ucw-gadgets/ventilation-control/README.md

# ventilation-control
Board for controlling ventilation system
