ucw-gadgets/ventilation-control/hw/ventilation_control/ventilation_control.kicad_pcb

## KiCad design hw/ventilation_control/ventilation_control.kicad_pcb (2022-02-05)

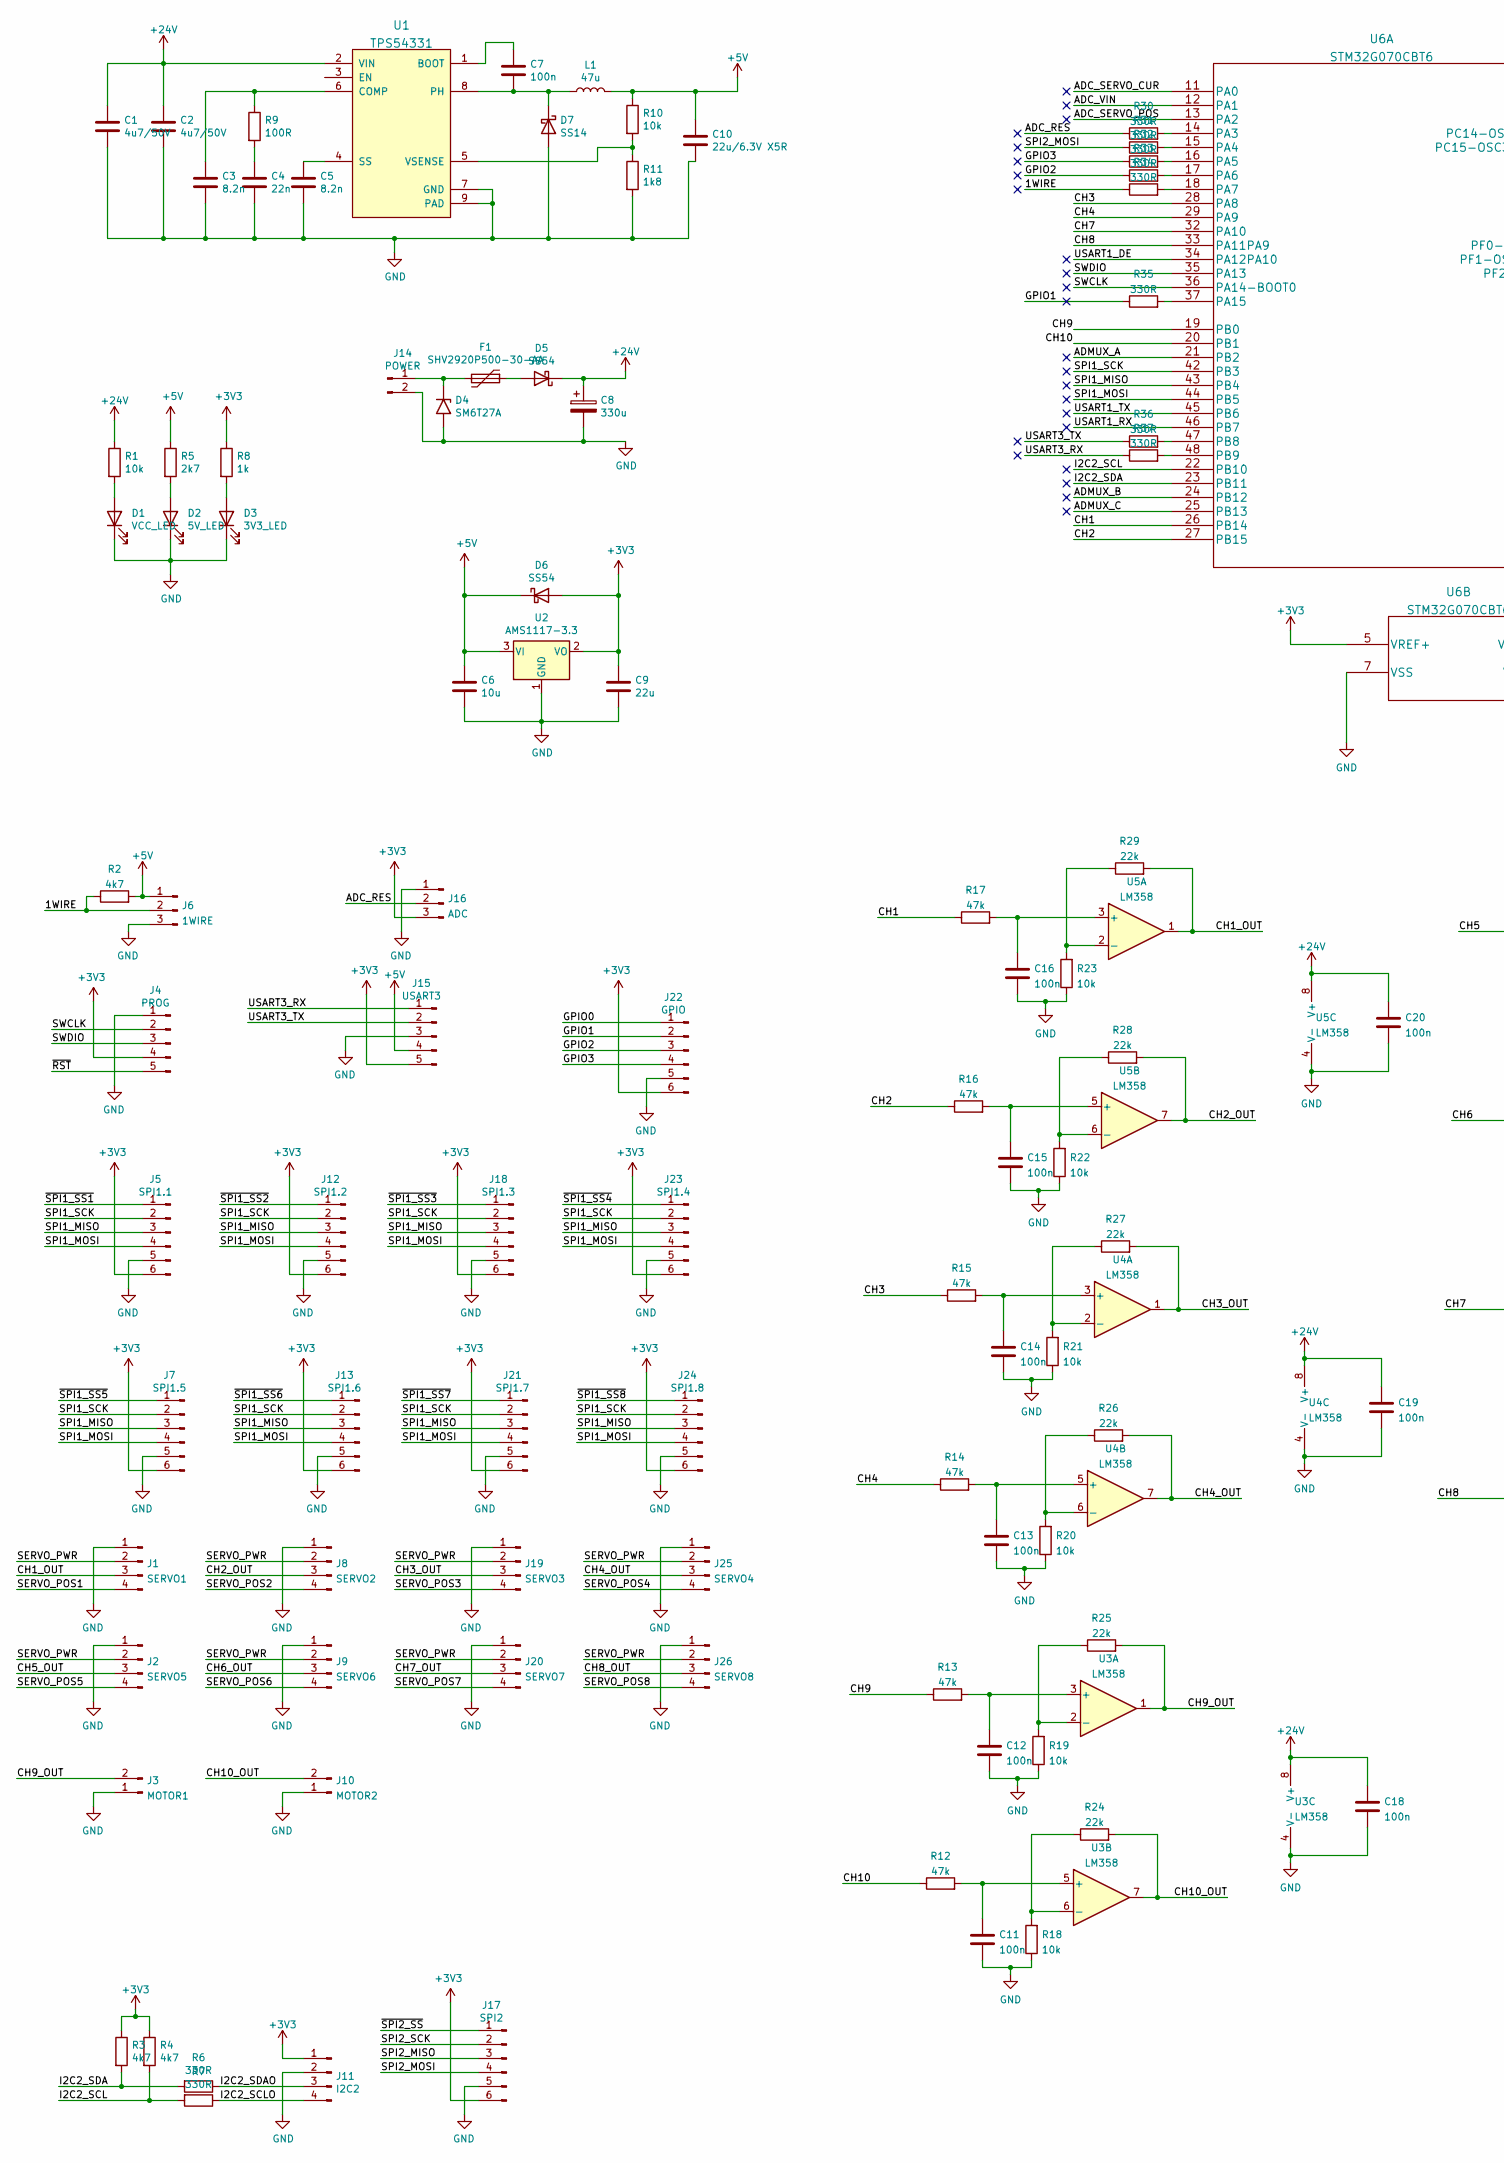
[picture p1: schematic ventilation_control.kicad_sch, part in row 1, column 1]

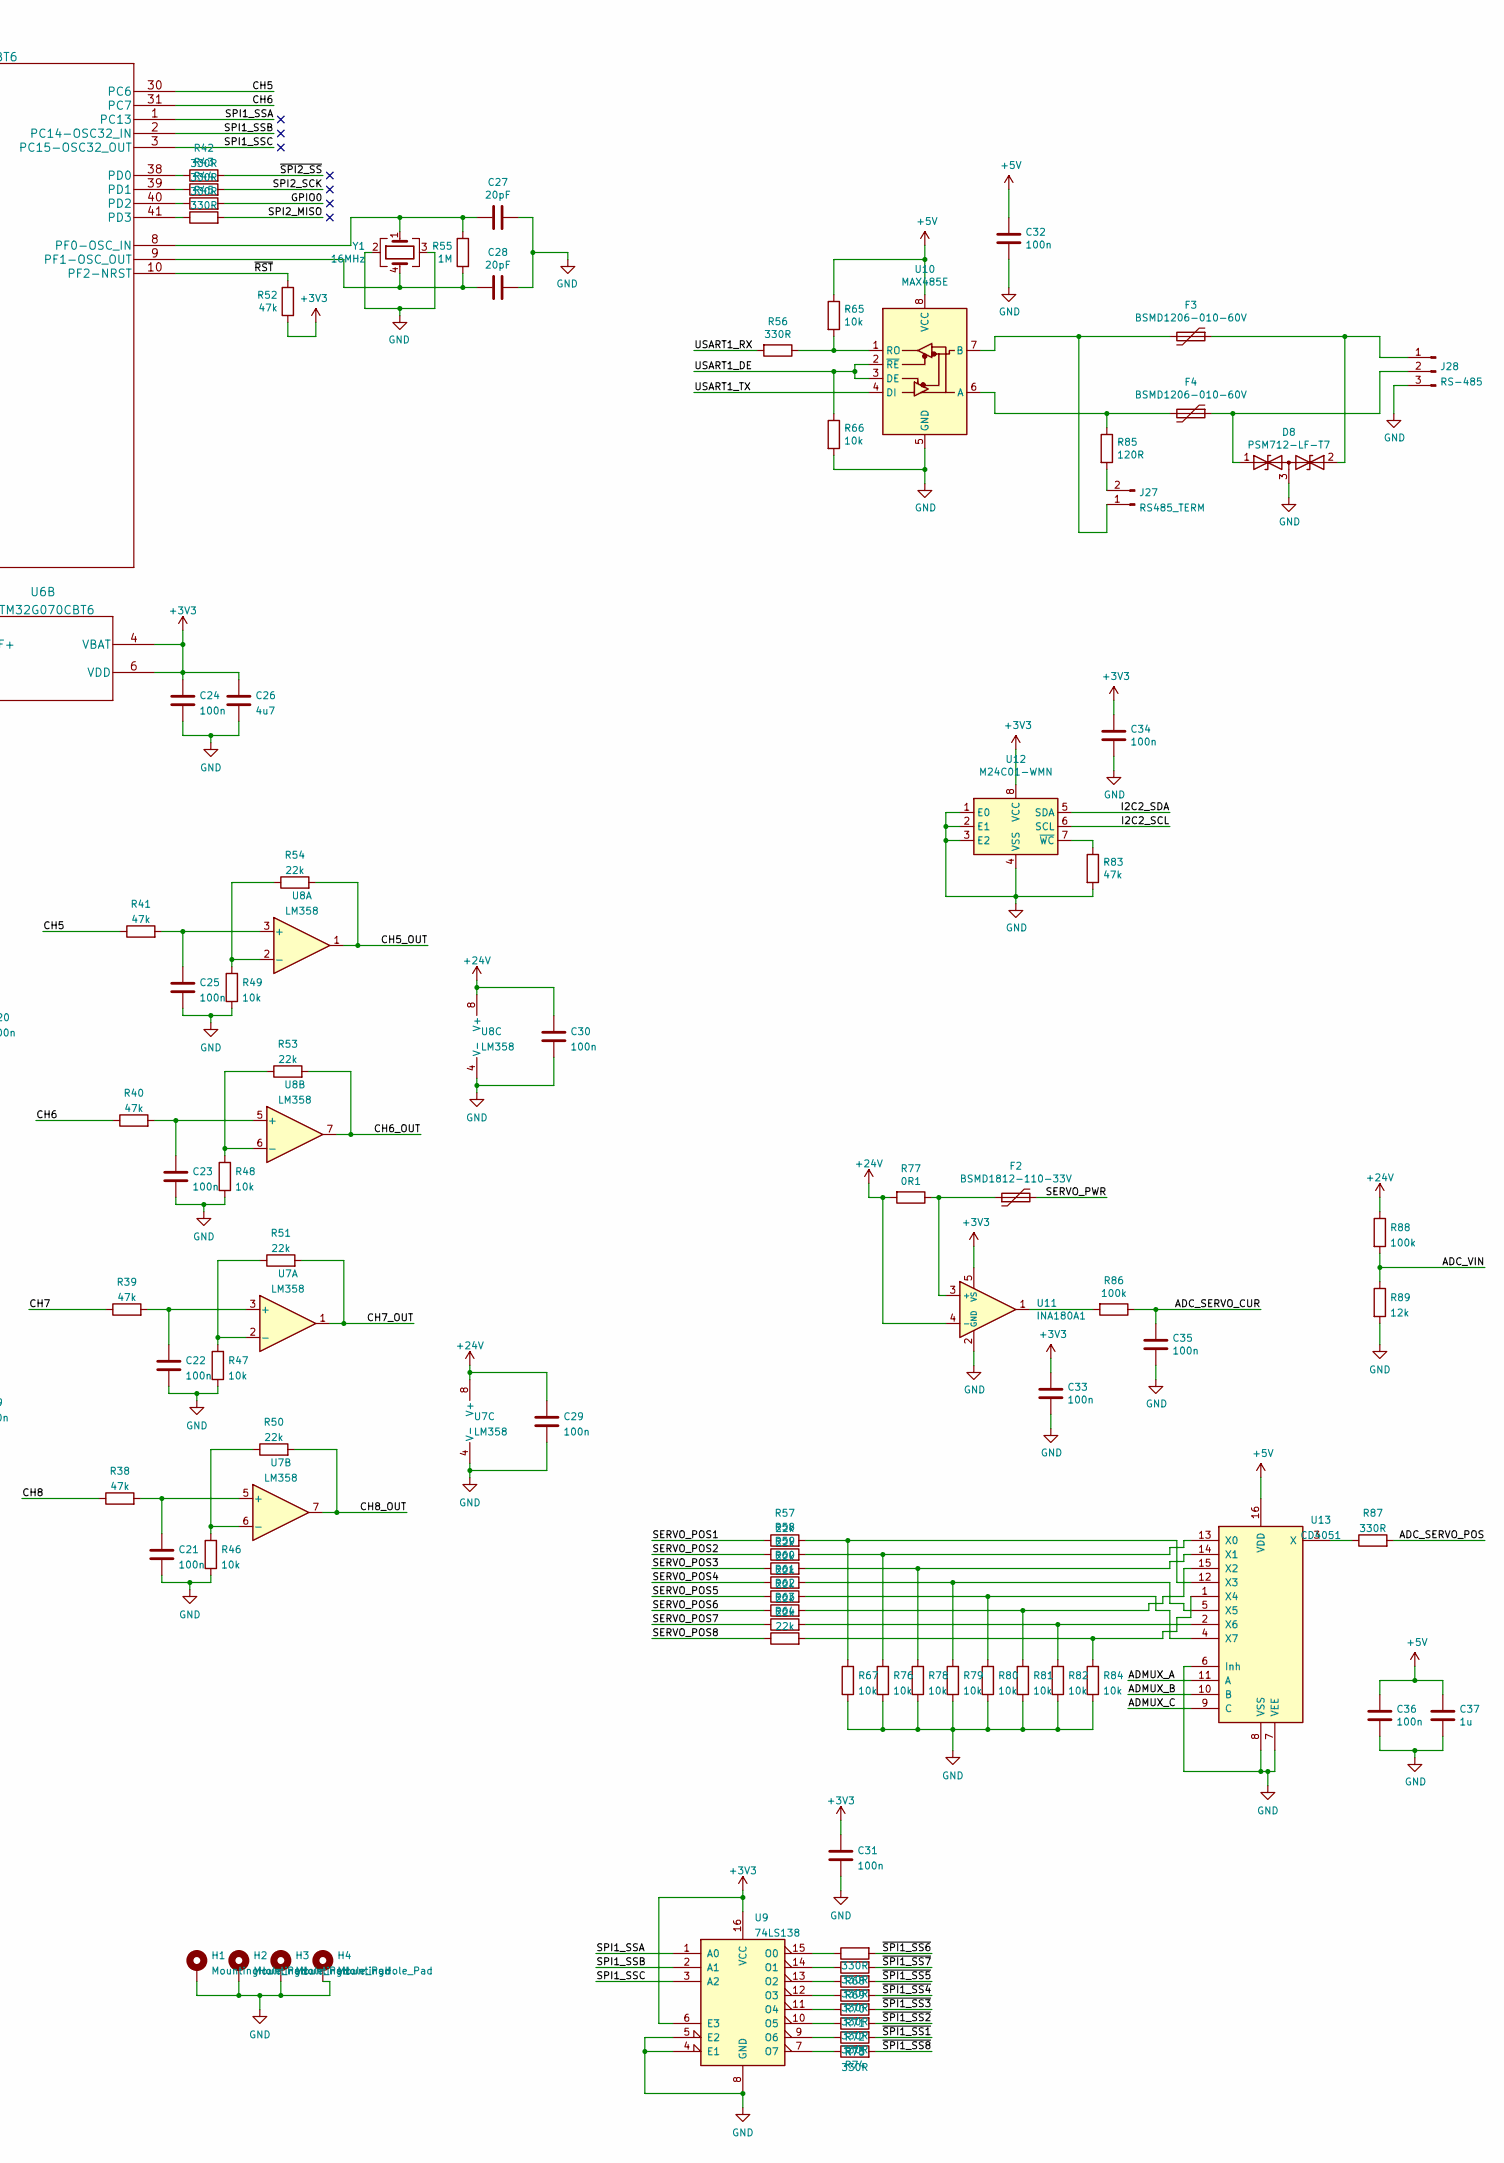
[picture p2: schematic ventilation_control.kicad_sch, part in row 1, column 2]

Parts:
C1, C2: 4u7/50V; C_1206_3216Metric; LCSC C29823
C3, C5: 8.2n; C_0603_1608Metric; LCSC C27920
C4: 22n; C_0603_1608Metric; LCSC C21122
C6: 10u; C_0603_1608Metric; LCSC C19702
C7, C11, C12, C13, C14, C15, C16, C18, C19, C20, C21, C22, C23, C24, C25, C29, C30, C31, C32, C33, C34, C35, C36: 100n; C_0603_1608Metric; LCSC C14663
C8: 330u; CP_Radial_D10.0mm_P5.00mm
C9: 22u; C_0603_1608Metric; LCSC C59461
C10: 22u/6.3V X5R; C_0603_1608Metric; LCSC C59461
C26: 4u7; C_1206_3216Metric; LCSC C29823
C27, C28: 20pF; C_0603_1608Metric; LCSC C1648
C37: 1u; C_0603_1608Metric; LCSC C15849
D1: VCC_LED; LED_0603_1608Metric; LCSC C72043
D2: 5V_LED; LED_0603_1608Metric; LCSC C72043
D3: 3V3_LED; LED_0603_1608Metric; LCSC C72043
D4: SM6T27A; D_SMB; LCSC C133693
D5, D6: SS54; D_SMA; LCSC C22452
D7: SS14; D_SMA; LCSC C2480
D8: PSM712-LF-T7; SOT-23; LCSC C32677
F1: SHV2920P500-30-AA; Fuse_2920_7451Metric; LCSC C495350
F2: BSMD1812-110-33V; Fuse_1812_4532Metric; LCSC C883150
F3, F4: BSMD1206-010-60V; Fuse_1206_3216Metric; LCSC C883116
H1, H2, H3, H4: MountingHole_Pad; MountingHole_3.2mm_M3_Pad_Via
J1: SERVO1; Molex_KK-254_AE-6410-04A_1x04_P2.54mm_Vertical
J2: SERVO5; Molex_KK-254_AE-6410-04A_1x04_P2.54mm_Vertical
J3: MOTOR1; Molex_KK-254_AE-6410-02A_1x02_P2.54mm_Vertical
J4: PROG; Molex_KK-254_AE-6410-05A_1x05_P2.54mm_Vertical
J5: SPI1.1; Molex_KK-254_AE-6410-06A_1x06_P2.54mm_Vertical
J6: 1WIRE; Molex_KK-254_AE-6410-03A_1x03_P2.54mm_Vertical
J7: SPI1.5; Molex_KK-254_AE-6410-06A_1x06_P2.54mm_Vertical
J8: SERVO2; Molex_KK-254_AE-6410-04A_1x04_P2.54mm_Vertical
J9: SERVO6; Molex_KK-254_AE-6410-04A_1x04_P2.54mm_Vertical
J10: MOTOR2; Molex_KK-254_AE-6410-02A_1x02_P2.54mm_Vertical
J11: I2C2; Molex_KK-254_AE-6410-04A_1x04_P2.54mm_Vertical
J12: SPI1.2; Molex_KK-254_AE-6410-06A_1x06_P2.54mm_Vertical
J13: SPI1.6; Molex_KK-254_AE-6410-06A_1x06_P2.54mm_Vertical
J14: POWER; PhoenixContact_MCV_1,5_2-GF-3.81_1x02_P3.81mm_Vertical_Thre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
J15: USART3; Molex_KK-254_AE-6410-05A_1x05_P2.54mm_Vertical
J16: ADC; Molex_KK-254_AE-6410-03A_1x03_P2.54mm_Vertical
J17: SPI2; Molex_KK-254_AE-6410-06A_1x06_P2.54mm_Vertical
J18: SPI1.3; Molex_KK-254_AE-6410-06A_1x06_P2.54mm_Vertical
J19: SERVO3; Molex_KK-254_AE-6410-04A_1x04_P2.54mm_Vertical
J20: SERVO7; Molex_KK-254_AE-6410-04A_1x04_P2.54mm_Vertical
J21: SPI1.7; Molex_KK-254_AE-6410-06A_1x06_P2.54mm_Vertical
J22: GPIO; Molex_KK-254_AE-6410-06A_1x06_P2.54mm_Vertical
J23: SPI1.4; Molex_KK-254_AE-6410-06A_1x06_P2.54mm_Vertical
J24: SPI1.8; Molex_KK-254_AE-6410-06A_1x06_P2.54mm_Vertical
J25: SERVO4; Molex_KK-254_AE-6410-04A_1x04_P2.54mm_Vertical
J26: SERVO8; Molex_KK-254_AE-6410-04A_1x04_P2.54mm_Vertical
J27: RS485_TERM; PinHeader_1x02_P2.54mm_Vertical
J28: RS-485; PhoenixContact_MCV_1,5_3-G-3.81_1x03_P3.81mm_Vertical
L1: 47u; L_Bourns_SRP7028A_7.3x6.6mm; LCSC C436585
R1, R10, R18, R19, R20, R21, R22, R23, R46, R47, R48, R49, R65, R66, R67, R76, R78, R79, R80, R81, R82, R84: 10k; R_0603_1608Metric; LCSC C25804
R2, R3, R4: 4k7; R_0603_1608Metric; LCSC C23162
R5: 2k7; R_0603_1608Metric; LCSC C13167
R6, R7, R30, R31, R32, R33, R34, R35, R36, R37, R42, R43, R44, R45, R56, R68, R69, R70, R71, R72, R73, R74, R75, R87: 330R; R_0603_1608Metric; LCSC C23138
R8: 1k; R_0603_1608Metric; LCSC C21190
R9: 100R; R_0603_1608Metric; LCSC C22775
R11: 1k8; R_0603_1608Metric; LCSC C4177
R12, R13, R14, R15, R16, R17, R38, R39, R40, R41, R52, R83: 47k; R_0603_1608Metric; LCSC C25819
R24, R25, R26, R27, R28, R29, R50, R51, R53, R54, R57, R58, R59, R60, R61, R62, R63, R64: 22k; R_0603_1608Metric; LCSC C31850
R55: 1M; R_0603_1608Metric; LCSC C22935
R77: 0R1; R_1206_3216Metric; LCSC C25334
R85: 120R; R_0603_1608Metric; LCSC C22787
R86, R88: 100k; R_0603_1608Metric; LCSC C25803
R89: 12k; R_0603_1608Metric; LCSC C22790
U1: TPS54331; SOIC-8_3.9x4.9mm_P1.27mm; LCSC C9865
U2: AMS1117-3.3; SOT-223-3_TabPin2; LCSC C6186
U3, U4, U5, U7, U8: LM358; SO-8_3.9x4.9mm_P1.27mm; LCSC C7950
U6: STM32G070CBT6; LQFP-48_7x7mm_P0.5mm
U9: 74LS138; SO-16_3.9x9.9mm_P1.27mm; LCSC C5602
U10: MAX485E; SOIC-8_3.9x4.9mm_P1.27mm; LCSC C6855
U11: INA180A1; SOT-23-5; LCSC C122228
U12: M24C01-WMN; SOIC-8_3.9x4.9mm_P1.27mm; LCSC C79988
U13: CD4051; SO-16_3.9x9.9mm_P1.27mm; LCSC C21379
Y1: 16MHz; Crystal_SMD_3225-4Pin_3.2x2.5mm; LCSC C13738

Connections:
+3V3: C9.1, C24.1, C26.1, C31.1, C33.1, C34.1, D6.2 (A), J4.4, J5.6, J7.6, J11.1, J12.6, J13.6, J15.5, J16.3, J17.6, J18.6, J21.6, J22.6, J23.6, J24.6, R3.1, R4.1, R8.1, R52.2, U2.2 (VO), U6.4 (VBAT), U6.5 (VREF+), U6.6 (VDD), U9.6 (E3), U9.16 (VCC), U11.5 (VS), U12.8 (VCC)
+5V: C6.1, C10.1, C32.1, C36.1, C37.1, D6.1 (K), J6.1, J15.4, L1.2, R2.2, R5.1, R10.1, R65.1, U2.3 (VI), U10.8 (VCC), U13.16 (VDD)
+24V: C1.1, C2.1, C8.1, C18.1, C19.1, C20.1, C29.1, C30.1, D5.1 (K), R1.1, R77.2, R88.1, U1.2 (VIN), U3.8 (V+), U4.8 (V+), U5.8 (V+), U7.8 (V+), U8.8 (V+), U11.4 (-)
/1WIRE: J6.2, R2.1, R34.1
/ADC_RES: J16.2, R30.1
/ADC_SERVO_CUR: C35.1, R86.1, U6.11 (PA0)
/ADC_SERVO_POS: R87.2, U6.13 (PA2)
/ADC_VIN: R88.2, R89.1, U6.12 (PA1)
/ADMUX_A: U6.21 (PB2), U13.11 (A)
/ADMUX_B: U6.24 (PB12), U13.10 (B)
/ADMUX_C: U6.25 (PB13), U13.9 (C)
/CH1: R17.1, U6.26 (PB14)
/CH1_OUT: J1.3, R29.2, U5.1
/CH2: R16.1, U6.27 (PB15)
/CH2_OUT: J8.3, R28.2, U5.7
/CH3: R15.1, U6.28 (PA8)
/CH3_OUT: J19.3, R27.2, U4.1
/CH4: R14.1, U6.29 (PA9)
/CH4_OUT: J25.3, R26.2, U4.7
/CH5: R41.1, U6.30 (PC6)
/CH5_OUT: J2.3, R54.2, U8.1
/CH6: R40.1, U6.31 (PC7)
/CH6_OUT: J9.3, R53.2, U8.7
/CH7: R39.1, U6.32 (PA10)
/CH7_OUT: J20.3, R51.2, U7.1
/CH8: R38.1, U6.33 (PA11PA9)
/CH8_OUT: J26.3, R50.2, U7.7
/CH9: R13.1, U6.19 (PB0)
/CH9_OUT: J3.2, R25.2, U3.1
/CH10: R12.1, U6.20 (PB1)
/CH10_OUT: J10.2, R24.2, U3.7
/GPIO0: J22.1, R44.2
/GPIO1: J22.2, R35.1
/GPIO2: J22.3, R33.1
/GPIO3: J22.4, R32.1
/I2C2_SCL: R4.2, R7.2, U6.22 (PB10), U12.6 (SCL)
/I2C2_SCLO: J11.4, R7.1
/I2C2_SDA: R3.2, R6.2, U6.23 (PB11), U12.5 (SDA)
/I2C2_SDAO: J11.3, R6.1
/SERVO_POS1: J1.4, R57.1
/SERVO_POS2: J8.4, R58.1
/SERVO_POS3: J19.4, R59.1
/SERVO_POS4: J25.4, R60.1
/SERVO_POS5: J2.4, R61.1
/SERVO_POS6: J9.4, R62.1
/SERVO_POS7: J20.4, R63.1
/SERVO_POS8: J26.4, R64.1
/SERVO_PWR: F2.2, J1.2, J2.2, J8.2, J9.2, J19.2, J20.2, J25.2, J26.2
/SPI1_MISO: J5.3, J7.3, J12.3, J13.3, J18.3, J21.3, J23.3, J24.3, U6.43 (PB4)
/SPI1_MOSI: J5.4, J7.4, J12.4, J13.4, J18.4, J21.4, J23.4, J24.4, U6.44 (PB5)
/SPI1_SCK: J5.2, J7.2, J12.2, J13.2, J18.2, J21.2, J23.2, J24.2, U6.42 (PB3)
/SPI1_SSA: U6.1 (PC13), U9.1 (A0)
/SPI1_SSB: U6.2 (PC14-OSC32_IN), U9.2 (A1)
/SPI1_SSC: U6.3 (PC15-OSC32_OUT), U9.3 (A2)
/SPI2_MISO: J17.3, R45.2
/SPI2_MOSI: J17.4, R31.1
/SPI2_SCK: J17.2, R43.2
/SWCLK: J4.2, U6.36 (PA14-BOOT0)
/SWDIO: J4.3, U6.35 (PA13)
/USART1_DE: R66.1, U6.34 (PA12PA10), U10.2 (~RE), U10.3 (DE)
/USART1_RX: R56.2, U6.46 (PB7)
/USART1_TX: U6.45 (PB6), U10.4 (DI)
/USART3_RX: J15.1, R37.1
/USART3_TX: J15.2, R36.1
/~RST: J4.5, R52.1, U6.10 (PF2-NRST)
/~SPI1_SS1: J5.1, R74.2
/~SPI1_SS2: J12.1, R73.2
/~SPI1_SS3: J18.1, R72.2
/~SPI1_SS4: J23.1, R71.2
/~SPI1_SS5: J7.1, R70.2
/~SPI1_SS6: J13.1, R68.2
/~SPI1_SS7: J21.1, R69.2
/~SPI1_SS8: J24.1, R75.2
/~SPI2_SS: J17.1, R42.2
GND: C1.2, C2.2, C3.2, C4.2, C5.2, C6.2, C8.2, C9.2, C10.2, C11.2, C12.2, C13.2, C14.2, C15.2, C16.2, C18.2, C19.2, C20.2, C21.2, C22.2, C23.2, C24.2, C25.2, C26.2, C27.2, C28.2, C29.2, C30.2, C31.2, C32.2, C33.2, C34.2, C35.2, C36.2, C37.2, D1.1 (K), D2.1 (K), D3.1 (K), D4.2 (A2), D7.2 (A), D8.3 (common), H1.1, H2.1, H3.1, H4.1, J1.1, J2.1, J3.1, J4.1, J5.5, J6.3, J7.5, J8.1, J9.1, J10.1, J11.2, J12.5, J13.5, J14.2, J15.3, J16.1, J17.5, J18.5, J19.1, J20.1, J21.5, J22.5, J23.5, J24.5, J25.1, J26.1, J28.3, R11.2, R18.1, R19.1, R20.1, R21.1, R22.1, R23.1, R46.1, R47.1, R48.1, R49.1, R66.2, R67.1, R76.1, R78.1, R79.1, R80.1, R81.1, R82.1, R83.2, R84.1, R89.2, U1.7 (GND), U1.9 (PAD), U2.1 (GND), U3.4 (V-), U4.4 (V-), U5.4 (V-), U6.7 (VSS), U7.4 (V-), U8.4 (V-), U9.4 (E1), U9.5 (E2), U9.8 (GND), U10.5 (GND), U11.2 (GND), U12.1 (E0), U12.2 (E1), U12.3 (E2), U12.4 (VSS), U13.6 (Inh), U13.7 (VEE), U13.8 (VSS), Y1.2, Y1.3
unnamed: C3.1, R9.1, U1.6 (COMP)
unnamed: C4.1, R9.2
unnamed: C5.1, U1.4 (SS)
unnamed: C7.1, U1.1 (BOOT)
unnamed: C7.2, D7.1 (K), L1.1, U1.8 (PH)
unnamed: C11.1, R12.2, U3.5 (+)
unnamed: C12.1, R13.2, U3.3 (+)
unnamed: C13.1, R14.2, U4.5 (+)
unnamed: C14.1, R15.2, U4.3 (+)
unnamed: C15.1, R16.2, U5.5 (+)
unnamed: C16.1, R17.2, U5.3 (+)
unnamed: C21.1, R38.2, U7.5 (+)
unnamed: C22.1, R39.2, U7.3 (+)
unnamed: C23.1, R40.2, U8.5 (+)
unnamed: C25.1, R41.2, U8.3 (+)
unnamed: C27.1, R55.1, U6.8 (PF0-OSC_IN), Y1.1
unnamed: C28.1, R55.2, U6.9 (PF1-OSC_OUT), Y1.4
unnamed: D1.2 (A), R1.2
unnamed: D2.2 (A), R5.2
unnamed: D3.2 (A), R8.2
unnamed: D4.1 (A1), F1.2, J14.1
unnamed: D5.2 (A), F1.1
unnamed: D8.1 (A1), F4.1, J28.2
unnamed: D8.2 (A2), F3.1, J28.1
unnamed: F2.1, R77.1, U11.3 (+)
unnamed: F3.2, J27.1, U10.7 (B)
unnamed: F4.2, R85.1, U10.6 (A)
unnamed: J27.2, R85.2
unnamed: R10.2, R11.1, U1.5 (VSENSE)
unnamed: R18.2, R24.1, U3.6 (-)
unnamed: R19.2, R25.1, U3.2 (-)
unnamed: R20.2, R26.1, U4.6 (-)
unnamed: R21.2, R27.1, U4.2 (-)
unnamed: R22.2, R28.1, U5.6 (-)
unnamed: R23.2, R29.1, U5.2 (-)
unnamed: R30.2, U6.14 (PA3)
unnamed: R31.2, U6.15 (PA4)
unnamed: R32.2, U6.16 (PA5)
unnamed: R33.2, U6.17 (PA6)
unnamed: R34.2, U6.18 (PA7)
unnamed: R35.2, U6.37 (PA15)
unnamed: R36.2, U6.47 (PB8)
unnamed: R37.2, U6.48 (PB9)
unnamed: R42.1, U6.38 (PD0)
unnamed: R43.1, U6.39 (PD1)
unnamed: R44.1, U6.40 (PD2)
unnamed: R45.1, U6.41 (PD3)
unnamed: R46.2, R50.1, U7.6 (-)
unnamed: R47.2, R51.1, U7.2 (-)
unnamed: R48.2, R53.1, U8.6 (-)
unnamed: R49.2, R54.1, U8.2 (-)
unnamed: R56.1, R65.2, U10.1 (RO)
unnamed: R57.2, R67.2, U13.12 (X3)
unnamed: R58.2, R76.2, U13.13 (X0)
unnamed: R59.2, R78.2, U13.14 (X1)
unnamed: R60.2, R79.2, U13.5 (X5)
unnamed: R61.2, R80.2, U13.4 (X7)
unnamed: R62.2, R81.2, U13.15 (X2)
unnamed: R63.2, R82.2, U13.2 (X6)
unnamed: R64.2, R84.2, U13.1 (X4)
unnamed: R68.1, U9.15 (O0)
unnamed: R69.1, U9.14 (O1)
unnamed: R70.1, U9.13 (O2)
unnamed: R71.1, U9.12 (O3)
unnamed: R72.1, U9.11 (O4)
unnamed: R73.1, U9.10 (O5)
unnamed: R74.1, U9.9 (O6)
unnamed: R75.1, U9.7 (O7)
unnamed: R83.1, U12.7 (~WC)
unnamed: R86.2, U11.1
unnamed: R87.1, U13.3 (X)

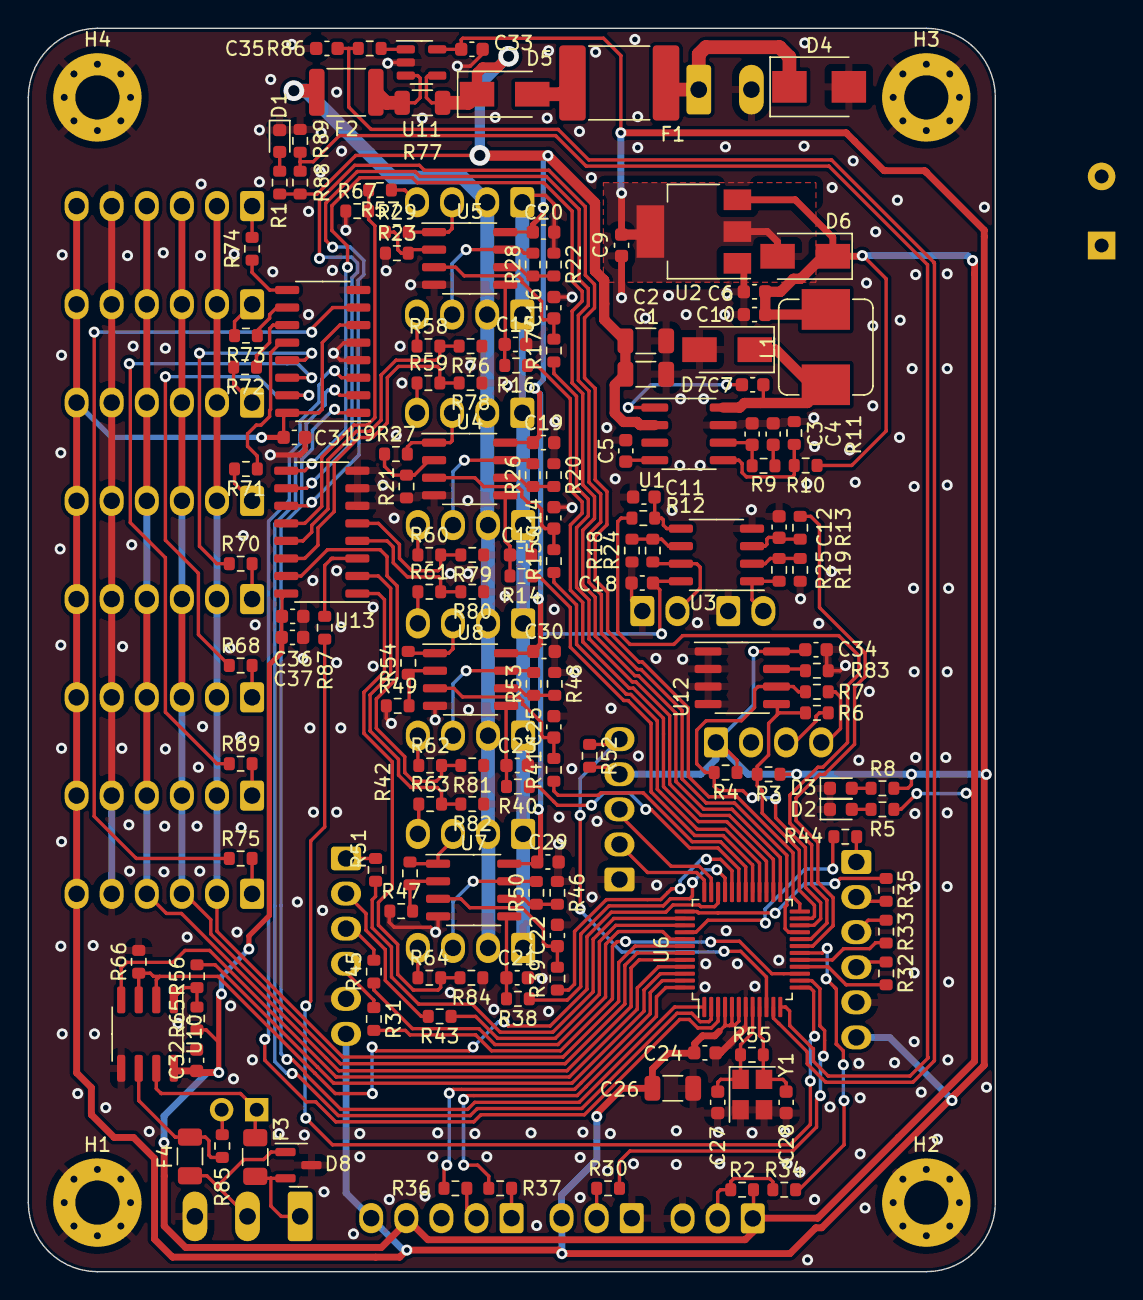
[picture p3: board ventilation_control.kicad_pcb from above]

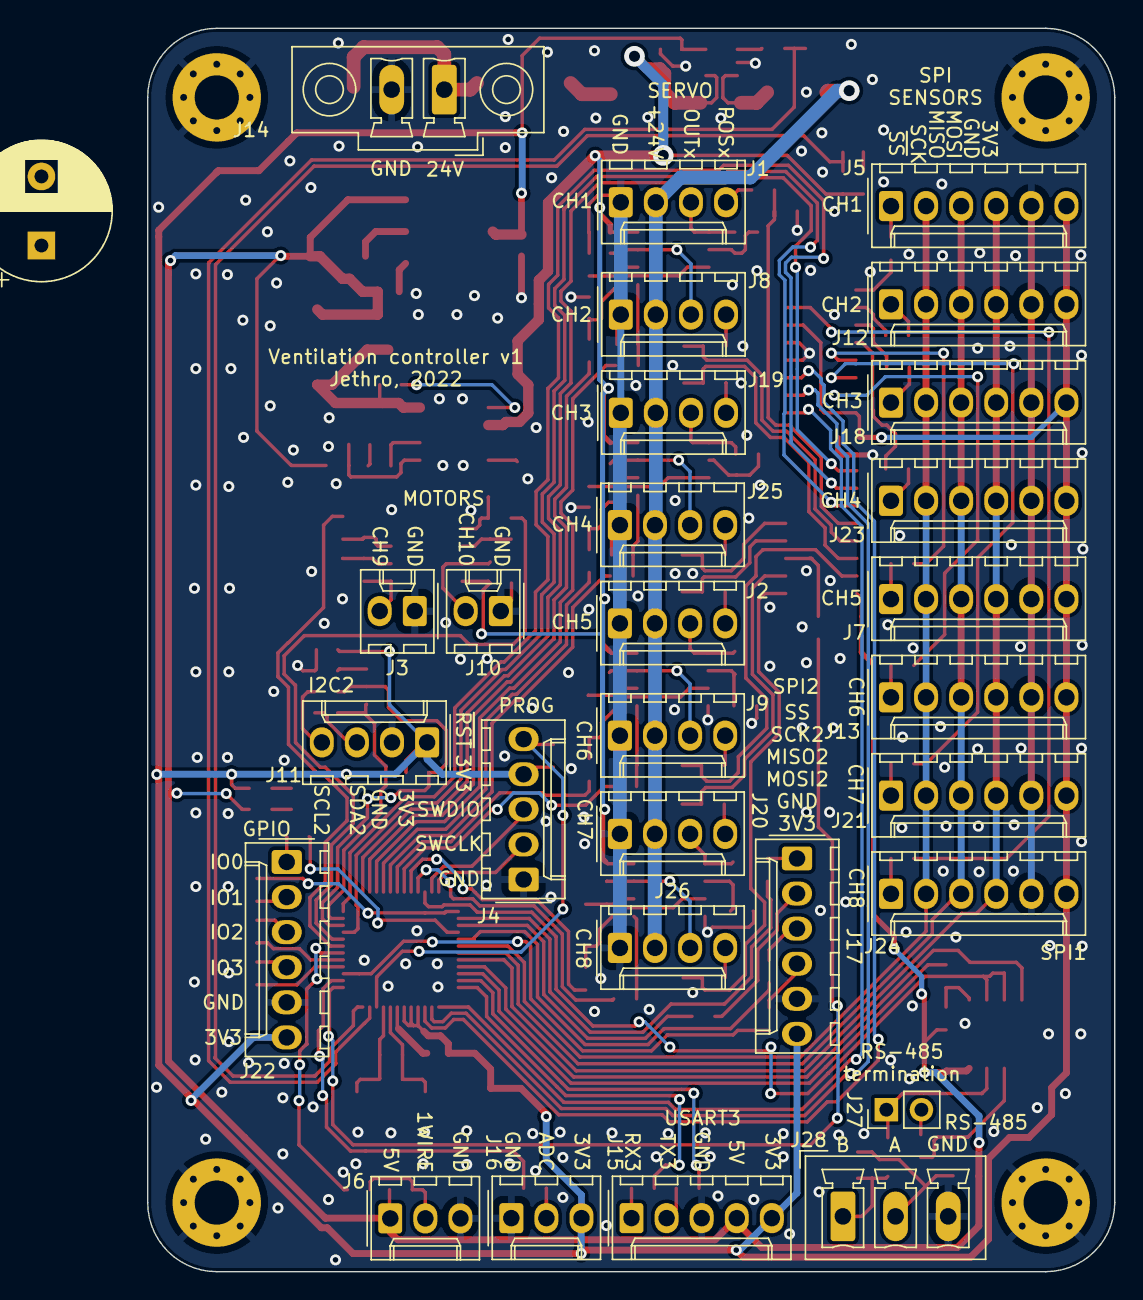
[picture p4: board ventilation_control.kicad_pcb from below]

Board: 2 copper layers, 70.0 x 90.0 mm, 184 parts (29 on the bottom side), 146 nets.
