ucw-gadgets/ventilation-control/(commit log)

2022-02-03 Added schematic and board.
    [ventilation_control.kicad_pcb, ventilation_control.kicad_sch]
2022-02-05 Final changes.
    [ventilation_control.kicad_pcb, ventilation_control.kicad_sch]
